frankemcgarvey/seniorDesign/pictures/Capture.PNG

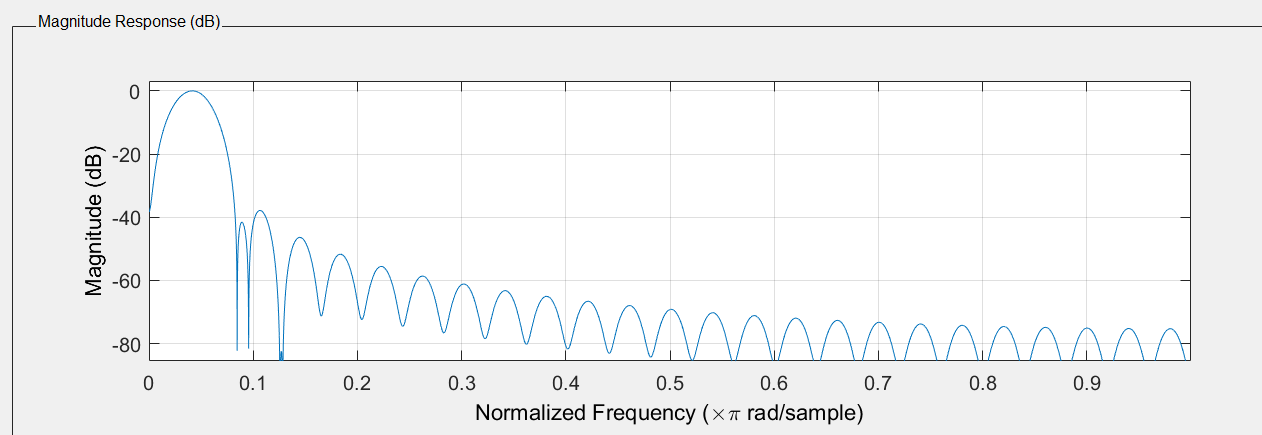
pictures/Capture.PNG
