frankemcgarvey/seniorDesign/Progress/Audio/251_tap_filter.PNG

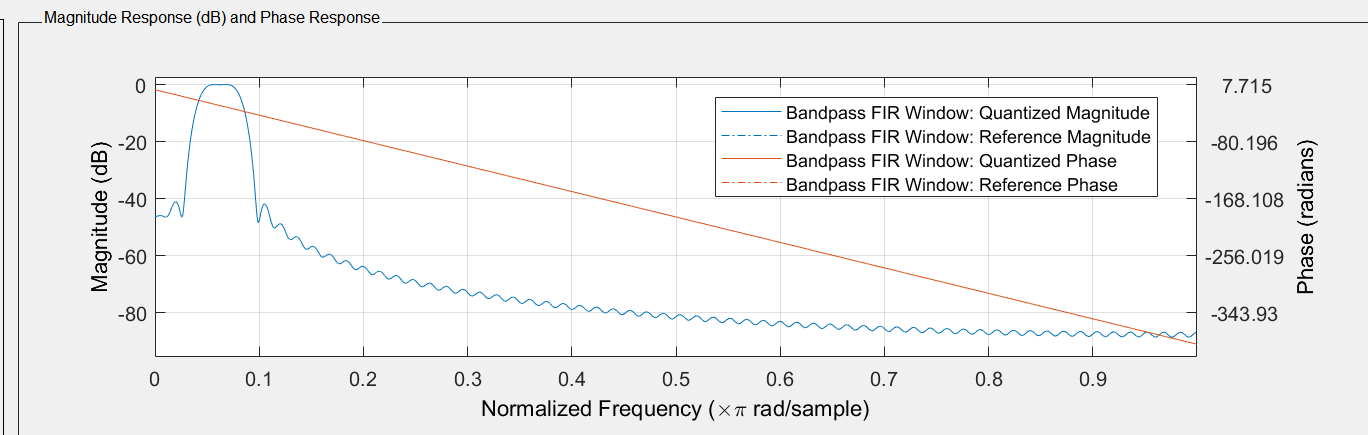
Progress/Audio/251_tap_filter.PNG
