frankemcgarvey/seniorDesign/Progress/Audio/clapping examples.PNG

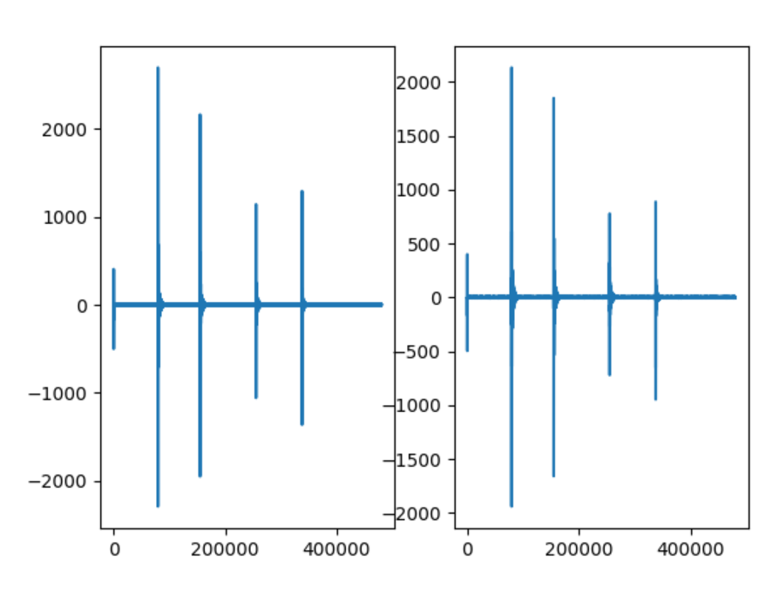
Progress/Audio/clapping examples.PNG
