frankemcgarvey/seniorDesign/Progress/Audio/FFT of 1khz-2khz clap.PNG

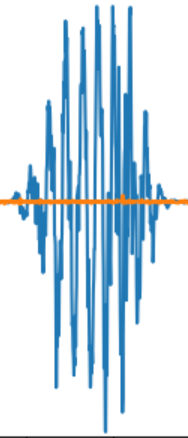
Progress/Audio/FFT of 1khz-2khz clap.PNG
