frankemcgarvey/seniorDesign/Progress/Audio/FFT of a 1khz and 3khz sine wave.PNG

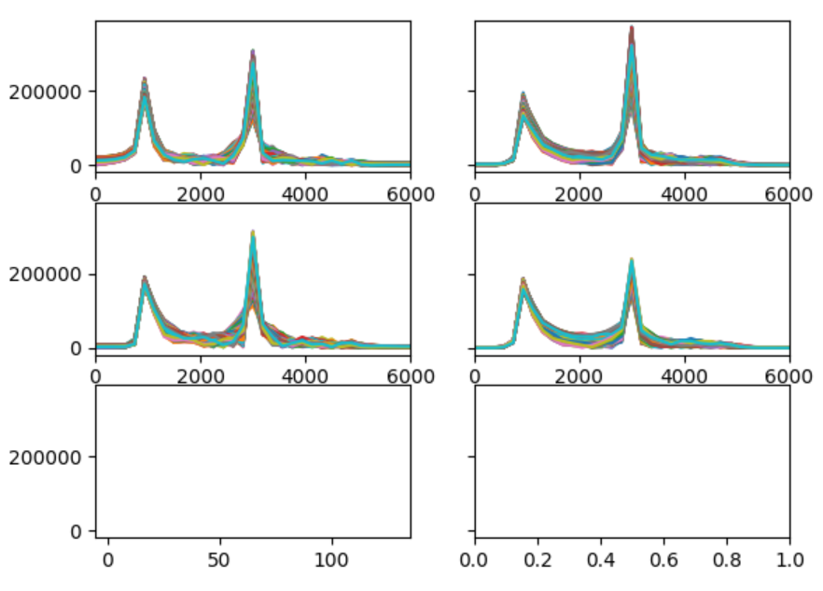
Progress/Audio/FFT of a 1khz and 3khz sine wave.PNG
