frankemcgarvey/seniorDesign/pictures/49_order.PNG

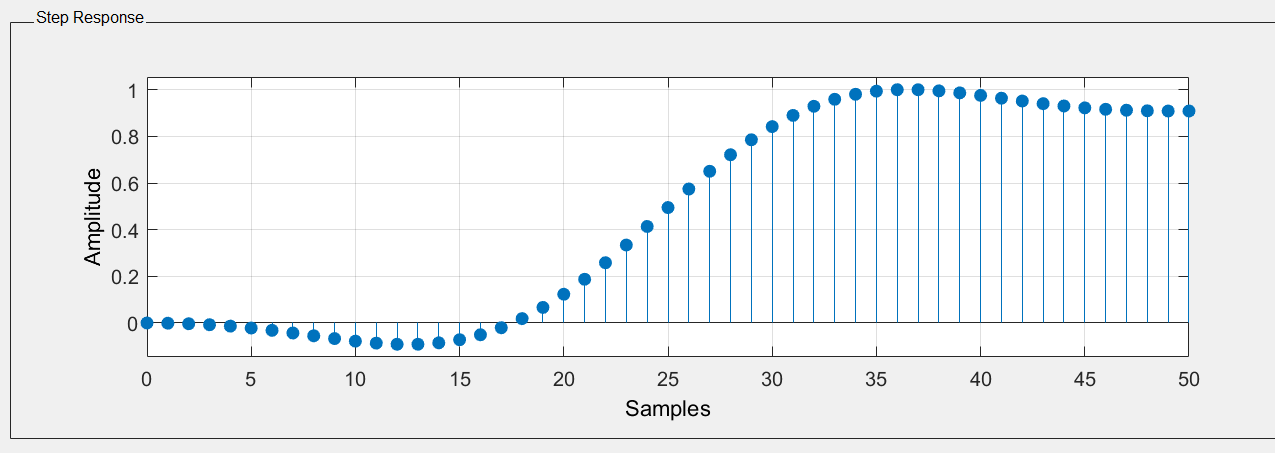
pictures/49_order.PNG
