frankemcgarvey/seniorDesign/pictures/99_order.PNG

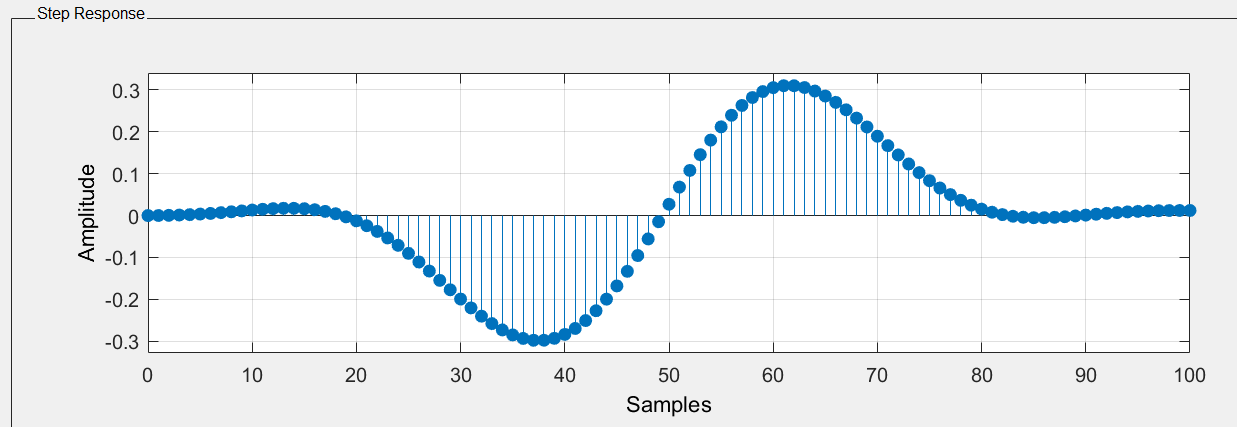
pictures/99_order.PNG
