frankemcgarvey/seniorDesign/PCB/mic_pcb/mic_pcb.kicad_pcb

## KiCad design PCB/mic_pcb/mic_pcb.kicad_pcb (2021-11-12)

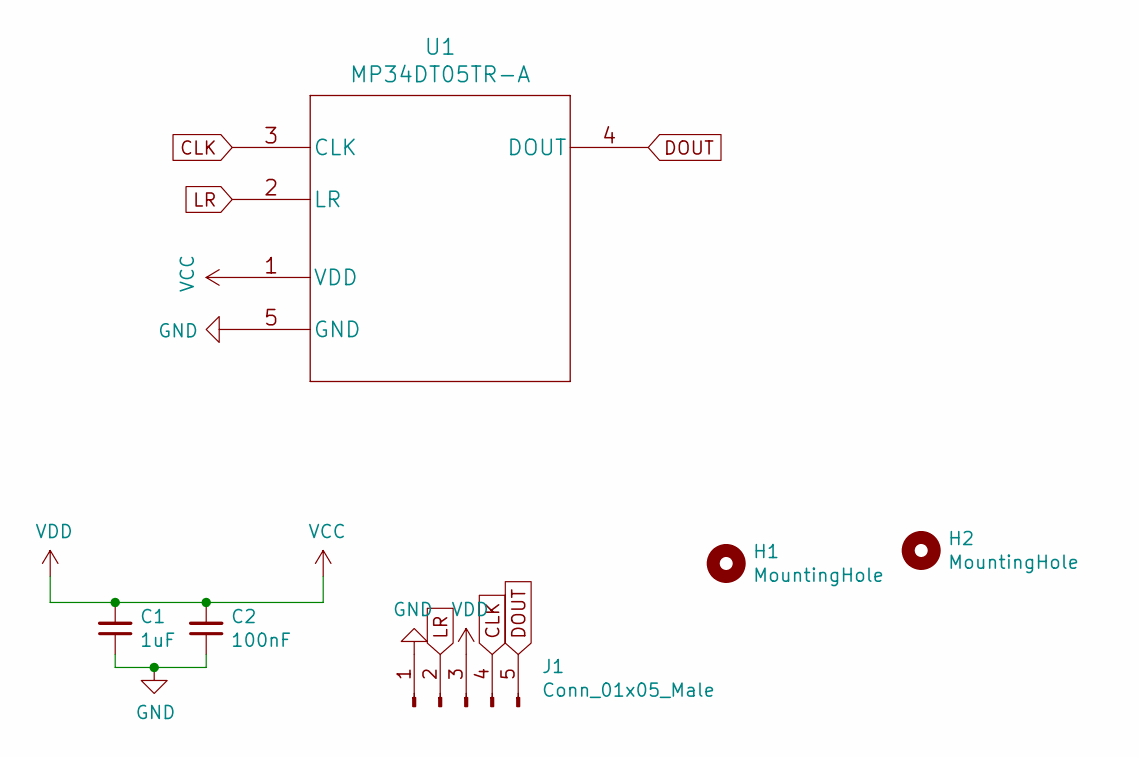
[picture p8: schematic mic_pcb.sch]

Parts:
C1: 1uF; C_0402_1005Metric; LCSC Part # C52923
C2: 100nF; C_0402_1005Metric; LCSC Part # C1525
H1, H2: MountingHole; MountingHole_2.2mm_M2_Pad_Via
J1: Conn_01x05_Male; PinHeader_1x05_P2.54mm_Vertical
U1: MP34DT05TR-A

Connections:
CLK: J1.4, U1.3 (CLK)
DOUT: J1.5, U1.4 (DOUT)
GND: C1.1, C2.1, J1.1, U1.5 (GND)
LR: J1.2, U1.2 (LR)
VCC: C1.2, C2.2, J1.3, U1.1 (VDD)

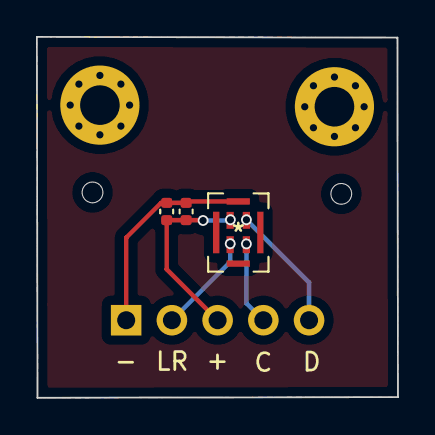
[picture p9: board mic_pcb.kicad_pcb from above]

Board: 2 copper layers, 20.1 x 20.0 mm, 6 parts (0 on the bottom side), 5 nets.
