frankemcgarvey/seniorDesign/PCB/stm32_pcb/stm32_pcb.kicad_pcb

## KiCad design PCB/stm32_pcb/stm32_pcb.kicad_pcb (2021-11-12)

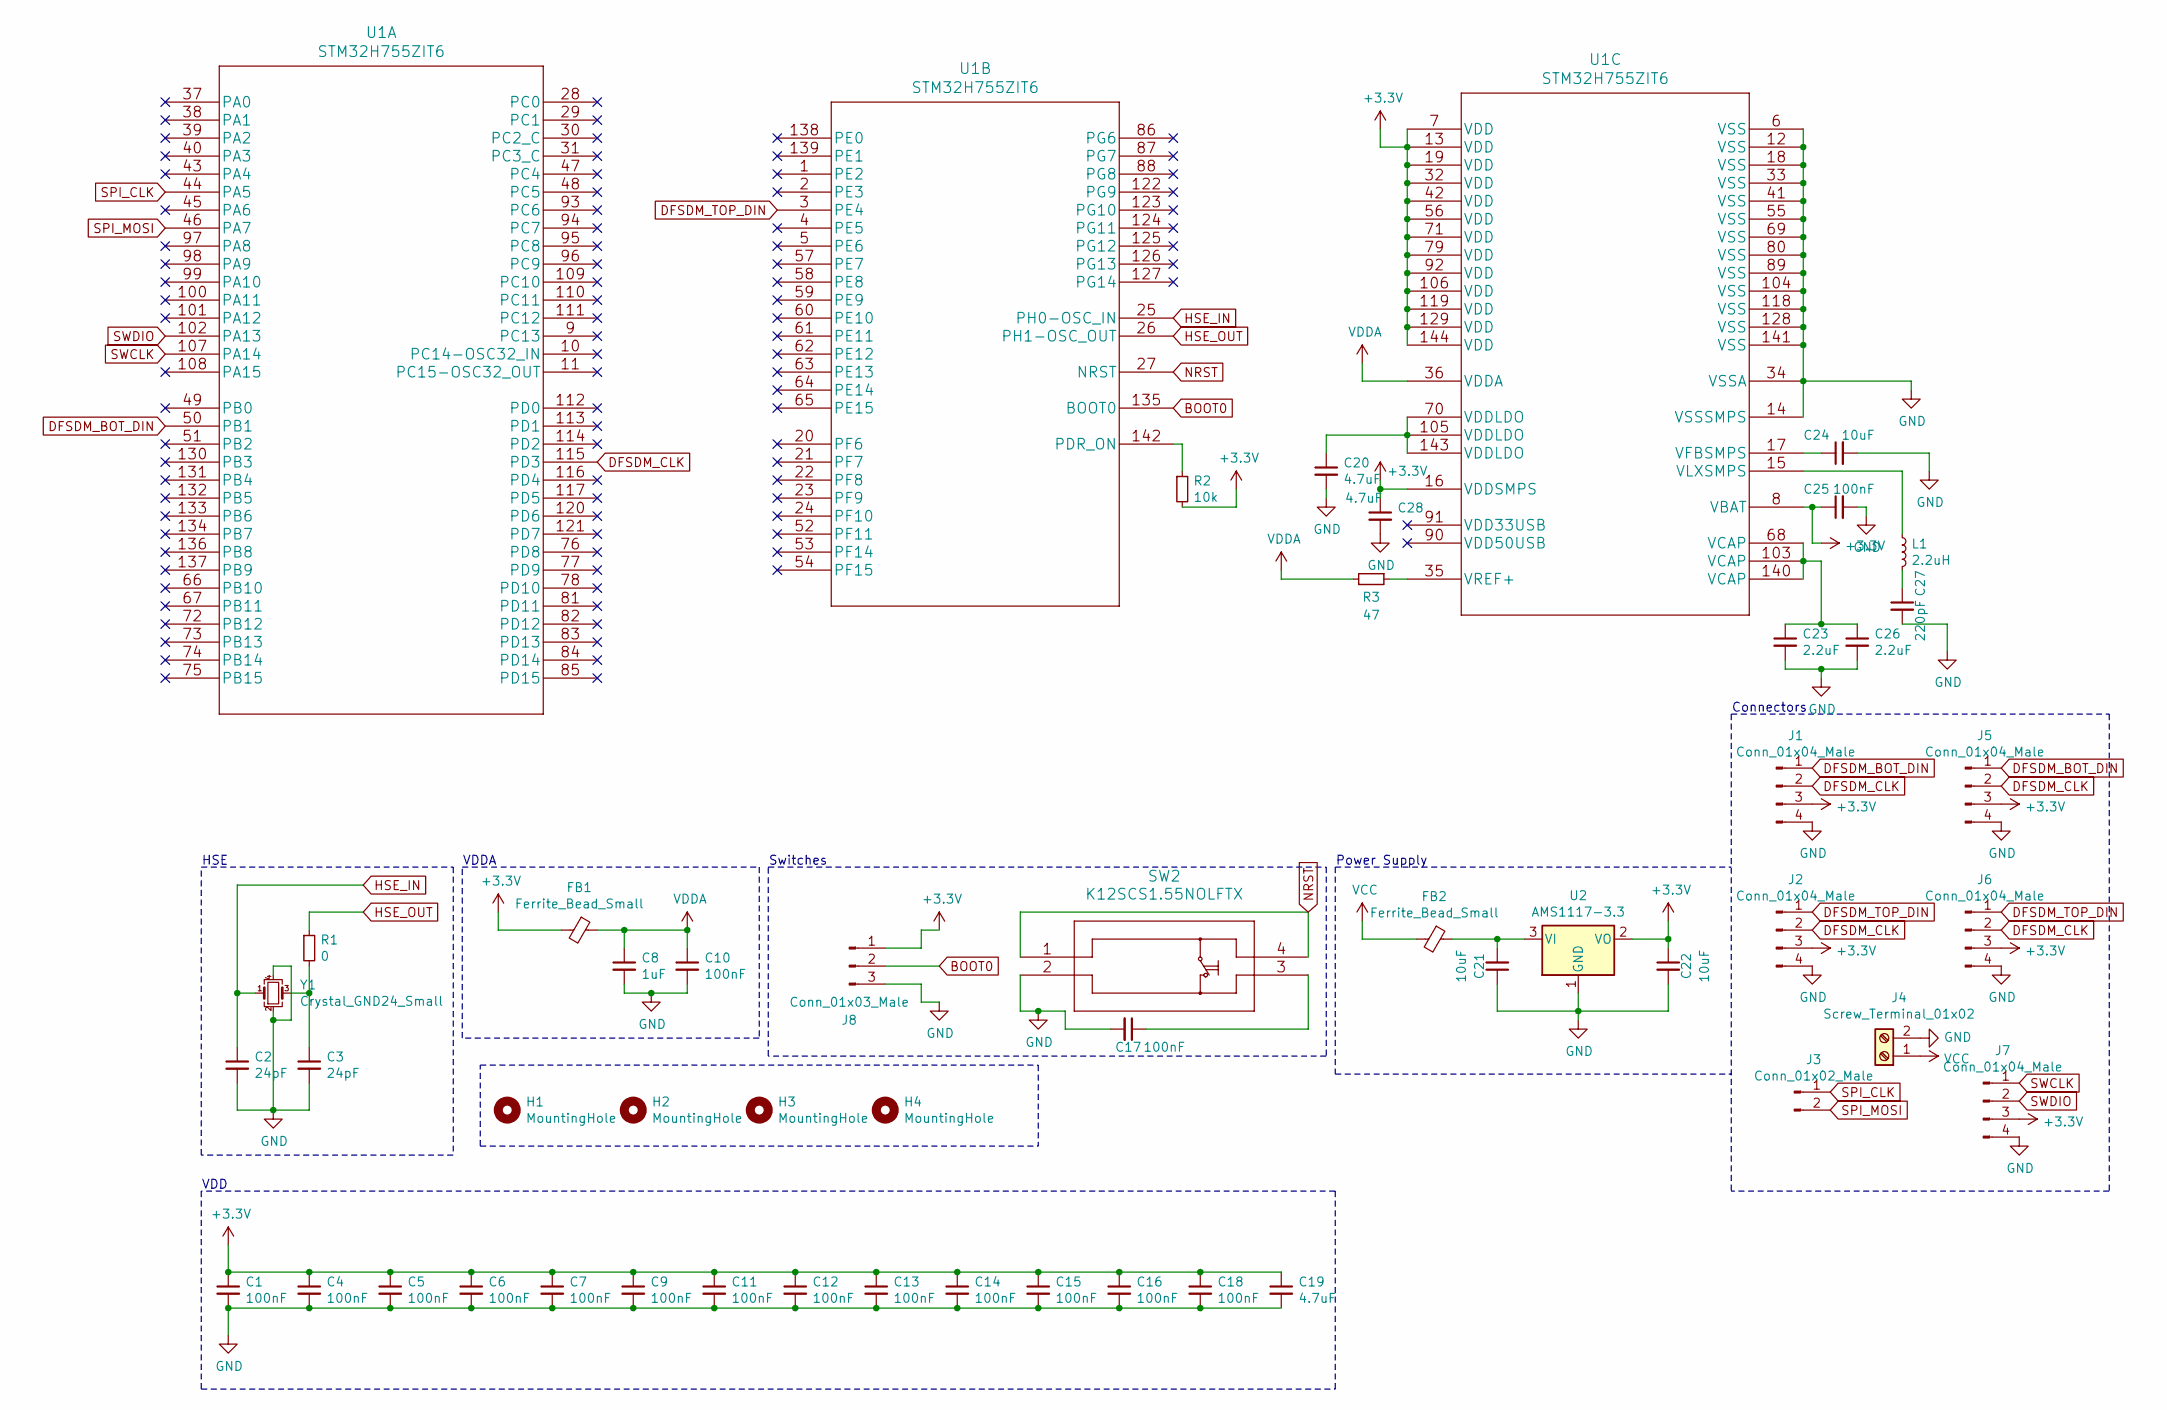
[picture p10: schematic stm32_pcb.sch]

Parts:
C1, C4, C5, C6, C7, C9, C10, C11, C12, C13, C14, C15, C16, C17, C18, C25: 100nF; C_0402_1005Metric; LCSC Part # C1525
C2, C3: 24pF; C_0402_1005Metric; LCSC Part # C22728
C8: 1uF; C_0402_1005Metric; LCSC Part # C52923
C19, C20, C28: 4.7uF; C_0402_1005Metric; LCSC Part # C23733
C21, C22: 10uF; C_0805_2012Metric; LCSC Part # C15850
C23, C26: 2.2uF; C_0402_1005Metric; LCSC Part # C12530
C24: 10uF; C_0402_1005Metric; LCSC Part # C15525
C27: 220pF; C_0402_1005Metric; LCSC Part # C1530
FB1, FB2: Ferrite_Bead_Small; L_0805_2012Metric; LCSC Part # C1015
H1, H2, H3, H4: MountingHole; MountingHole_4.3mm_M4_Pad_Via
J1, J2, J5, J6, J7: Conn_01x04_Male; PinHeader_1x04_P2.54mm_Vertical
J3: Conn_01x02_Male; PinHeader_1x02_P2.54mm_Vertical
J4: Screw_Terminal_01x02; TerminalBlock_Phoenix_PT-1,5-2-3.5-H_1x02_P3.50mm_Horizontal
J8: Conn_01x03_Male; PinHeader_1x03_P2.54mm_Vertical
L1: 2.2uH; L_0805_2012Metric; LCSC Part # C1043
R1: 0; R_0402_1005Metric; LCSC Part # C17168
R2: 10k; R_0402_1005Metric; LCSC Part # C25744
R3: 47; R_0402_1005Metric; LCSC Part # C25118
SW2: K12SCS1.55NOLFTX
U1: STM32H755ZIT6
U2: AMS1117-3.3; SOT-223-3_TabPin2; LCSC Part # C6186
Y1: Crystal_GND24_Small; OSC_ABM3B-8.000MHZ-B2-T; LCSC Part # C83312

Connections:
+3V3: C1.1, C4.1, C5.1, C6.1, C7.1, C9.1, C11.1, C12.1, C13.1, C14.1, C15.1, C16.1, C18.1, C19.1, C22.1, C25.1, C28.1, FB1.2, J1.3, J2.3, J5.3, J6.3, J7.3, J8.1, R2.2, U1.7 (VDD), U1.8 (VBAT), U1.13 (VDD), U1.16 (VDDSMPS), U1.19 (VDD), U1.32 (VDD), U1.42 (VDD), U1.56 (VDD), U1.71 (VDD), U1.79 (VDD), U1.92 (VDD), U1.106 (VDD), U1.119 (VDD), U1.129 (VDD), U1.144 (VDD), U2.2 (VO)
BOOT0: J8.2, U1.135 (BOOT0)
DFSDM_BOT_DIN: J1.1, J5.1, U1.50 (PB1)
DFSDM_CLK: J1.2, J2.2, J5.2, J6.2, U1.115 (PD3)
DFSDM_TOP_DIN: J2.1, J6.1, U1.3 (PE4)
GND: C1.2, C2.2, C3.2, C4.2, C5.2, C6.2, C7.2, C8.2, C9.2, C10.2, C11.2, C12.2, C13.2, C14.2, C15.2, C16.2, C17.2, C18.2, C19.2, C20.2, C21.1, C22.2, C23.2, C24.2, C25.2, C26.2, C27.2, C28.2, J1.4, J2.4, J4.2, J5.4, J6.4, J7.4, J8.3, SW2.2, U1.6 (VSS), U1.12 (VSS), U1.14 (VSSSMPS), U1.18 (VSS), U1.33 (VSS), U1.34 (VSSA), U1.41 (VSS), U1.55 (VSS), U1.69 (VSS), U1.80 (VSS), U1.89 (VSS), U1.104 (VSS), U1.118 (VSS), U1.128 (VSS), U1.141 (VSS), U2.1 (GND), Y1.2, Y1.4
HSE_IN: C2.1, U1.25 (PH0-OSC_IN), Y1.1
HSE_OUT: R1.1, U1.26 (PH1-OSC_OUT)
NRST: SW2.1, SW2.4, U1.27 (NRST)
unnamed: C3.1, R1.2, Y1.3
unnamed: C17.1, SW2.3
unnamed: C20.1, U1.70 (VDDLDO), U1.105 (VDDLDO), U1.143 (VDDLDO)
unnamed: C21.2, FB2.1, U2.3 (VI)
unnamed: C23.1, C26.1, U1.68 (VCAP), U1.103 (VCAP), U1.140 (VCAP)
unnamed: C24.1, U1.17 (VFBSMPS)
unnamed: C27.1, L1.2
unnamed: L1.1, U1.15 (VLXSMPS)
unnamed: R2.1, U1.142 (PDR_ON)
unnamed: R3.1, U1.35 (VREF+)
SPI_CLK: J3.1, U1.44 (PA5)
SPI_MOSI: J3.2, U1.46 (PA7)
SWCLK: J7.1, U1.107 (PA14)
SWDIO: J7.2, U1.102 (PA13)
VCC: FB2.2, J4.1
VDDA: C8.1, C10.1, FB1.1, R3.2, U1.36 (VDDA)

Notes on the sheet:
HSE
VDDA
Switches
VDD
Power Supply
Connectors

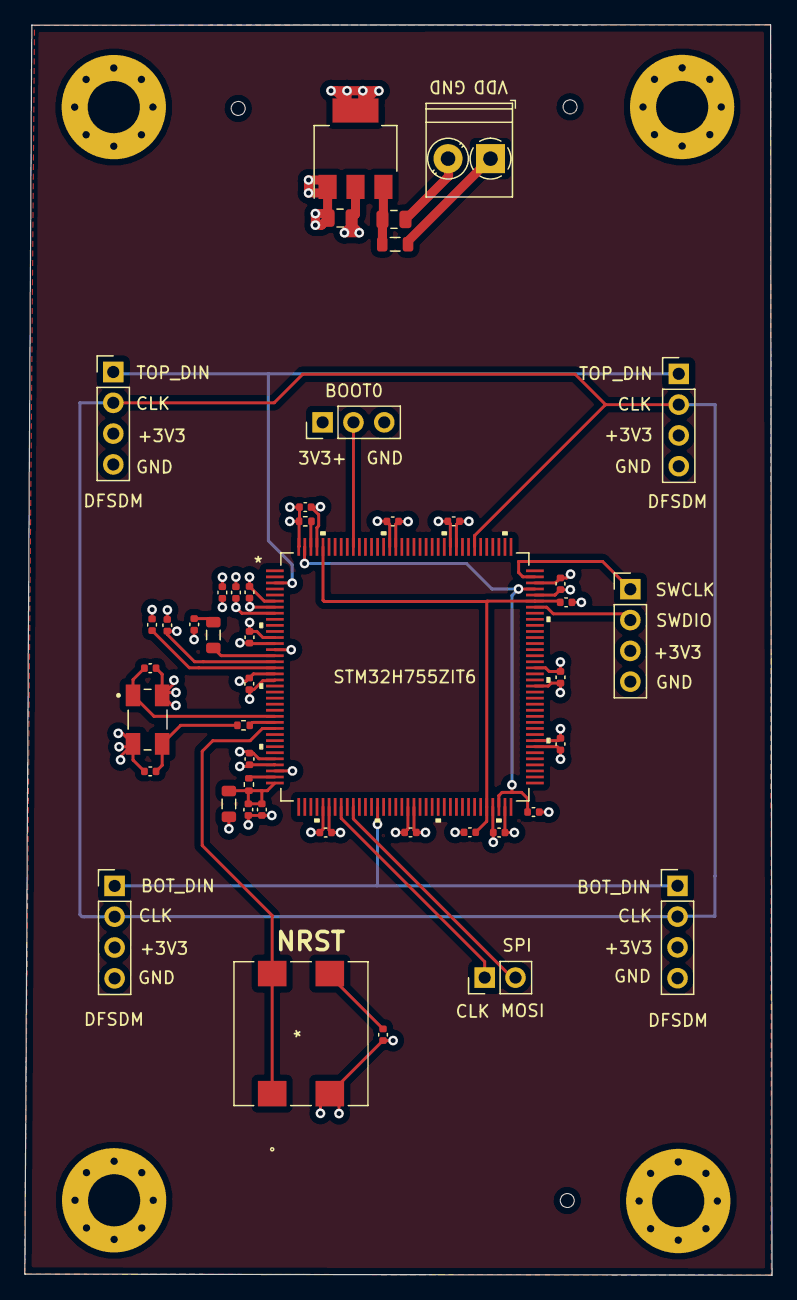
[picture p11: board stm32_pcb.kicad_pcb from above]

Board: 4 copper layers, 61.6 x 103.1 mm, 50 parts (0 on the bottom side), 25 nets.
