frankemcgarvey/seniorDesign/seniorProject/SPI_relay/SPI_relay.ioc

PB14.GPIO_Label=LD3 [Red Led]
PB13.Signal=ETH_TXD1
PG13.Signal=ETH_TXD0
PE1.Signal=GPIO_Output
PA8.Signal=USB_OTG_FS_SOF
PD9.GPIO_Label=STLINK_TX
PC13.Signal=GPIO_Input
PD10.Signal=GPIO_Output
PA9.Signal=USB_OTG_FS_VBUS
PB10.Signal=SPI2_SCK
PB14.Signal=GPIO_Output
PA5.Signal=SPI1_SCK
PE1.GPIO_Label=LD2 [Yellow Led]
PG7.GPIO_Label=USB_OTG_FS_OVCR
PA11.Signal=USB_OTG_FS_DM
PB0.Signal=GPIO_Output
PC1.Signal=ETH_MDC
Mcu.UserName=STM32H755ZITx
PB0.GPIO_Label=LD1 [Green Led]
PC13.GPIO_Label=B1 [Blue PushButton]
PG11.Signal=ETH_TX_EN
PA12.Signal=USB_OTG_FS_DP
PC2_C.Signal=SPI2_MISO
PA6.Signal=SPI1_MISO
PC5.Signal=ETH_RXD1
PG7.Signal=GPXTI7
PC4.Signal=ETH_RXD0
PD9.Signal=USART3_RX
PD10.GPIO_Label=USB_OTG_FS_PWR_EN
PA1.Signal=ETH_REF_CLK
PA2.Signal=ETH_MDIO
PA7.Signal=ETH_CRS_DV
