frankemcgarvey/seniorDesign/senior_project/microphone/CM7/Core/Src/main.c

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
/* Includes ------------------------------------------------------------------*/
#include "main.h"

/* USER CODE BEGIN Includes */
#include "stdbool.h"
/* USER CODE END Includes */

/* USER CODE BEGIN PTD */


typedef enum{
	NONE,
	BUSY,
	READY,
	DONE,
	HALF,
	FULL,
}flag_t;

/* USER CODE END PTD */

/* USER CODE BEGIN PD */

#ifndef HSEM_ID_0
#define HSEM_ID_0 (0U) /* HW semaphore 0*/
#endif


/* USER CODE END PD */


CRC_HandleTypeDef hcrc;

SAI_HandleTypeDef hsai_BlockA1;
DMA_HandleTypeDef hdma_sai1_a;

TIM_HandleTypeDef htim1;

UART_HandleTypeDef huart3;
DMA_HandleTypeDef hdma_usart3_tx;

/* USER CODE BEGIN PV */

static volatile flag_t dmaFlag = NONE;
static volatile flag_t timFlag = NONE;
static buffer_t * const buffer = (buffer_t *) 0x30000000;
static dsp_buffer_t dsp[CHANNEL_NUMBER];
static float coeff[TAPS] = {-0.0000001708, -0.0000002072, -0.0000002839, -0.0000004056, -0.0000005722, -0.0000007792, -0.0000010175, -0.0000012738, -0.0000015317, -0.0000017714, -0.0000019718, -0.0000021107, -0.0000021664, -0.0000021195, -0.0000019540, -0.0000016590, -0.0000012305, -0.0000006729, 0.0000000000, 0.0000007640, 0.0000015840, 0.0000024139, 0.0000031980, 0.0000038724, 0.0000043672, 0.0000046105, 0.0000045326, 0.0000040711, 0.0000031769, 0.0000018207, 0.0000000000, -0.0000022540, -0.0000048702, -0.0000077314, -0.0000106698, -0.0000134641, -0.0000158383, -0.0000174636, -0.0000179629, -0.0000169184, -0.0000138833, -0.0000083961, 0.0000000000, 0.0000117360, 0.0000271918, 0.0000466687, 0.0000703603, 0.0000983228, 0.0001304450, 0.0001664201, 0.0002057210, 0.0002475790, 0.0002909693, 0.0003346029, 0.0003769283, 0.0004161424, 0.0004502125, 0.0004769106, 0.0004938592, 0.0004985898, 0.0004886130, 0.0004614993, 0.0004149700, 0.0003469949, 0.0002558953, 0.0001404502, -0.0000000000, -0.0001654534, -0.0003551552, -0.0005675193, -0.0008000660, -0.0010493804, -0.0013110950, -0.0015799000, -0.0018495834, -0.0021131027, -0.0023626911, -0.0025899960, -0.0027862496, -0.0029424720, -0.0030496991, -0.0030992355, -0.0030829236, -0.0029934247, -0.0028245046, -0.0025713127, -0.0022306510, -0.0018012194, -0.0012838305, -0.0006815852, 0.0000000000, 0.0007529215, 0.0015666786, 0.0024283314, 0.0033226281, 0.0042322059, 0.0051378626, 0.0060188994, 0.0068535269, 0.0076193302, 0.0082937833, 0.008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

  /* Enable D-Cache---------------------------------------------------------*/
  SCB_EnableDCache();

  /* MCU Configuration--------------------------------------------------------*/

  /* Reset of all peripherals, Initializes the Flash interface and the Systick. */
  HAL_Init();

  /* Configure the system clock */
  SystemClock_Config();
/* USER CODE BEGIN Boot_Mode_Sequence_2 */
/* When system initialization is finished, Cortex-M7 will release Cortex-M4 by means of
HSEM notification */
/*HW semaphore Clock enable*/
__HAL_RCC_HSEM_CLK_ENABLE();
/*Take HSEM */
HAL_HSEM_FastTake(HSEM_ID_0);
/*Release HSEM in order to notify the CPU2(CM4)*/
HAL_HSEM_Release(HSEM_ID_0,0);
/* wait until CPU2 wakes up from stop mode */
timeout = 0xFFFF;
while((__HAL_RCC_GET_FLAG(RCC_FLAG_D2CKRDY) == RESET) && (timeout-- > 0));
if ( timeout < 0 )
{
Error_Handler();
}
/* USER CODE END Boot_Mode_Sequence_2 */

  /* Initialize all configured peripherals */
  MX_GPIO_Init();
  MX_DMA_Init();
  MX_USART3_UART_Init();
  MX_CRC_Init();
  MX_SAI1_Init();
  MX_TIM1_Init();
  /* USER CODE BEGIN 2 */

  FIR_Filter_Init(&dsp[0], &coeff[0]);

  pdm_to_pcm_init((PDM_Filter_Handler_t*)&PDM_FilterHandler[0], (PDM_Filter_Config_t*)&PDM_FilterConfig[0]);

  timFlag = NONE;
  /* USER CODE END 2 */

  /* Infinite loop */
  /* USER CODE BEGIN WHILE */

  HAL_SAI_Receive_DMA(&hsai_BlockA1, (uint8_t*)&buffer->pdmBuffer[0], BUFFER_SIZE);

  HAL_Delay(2000);

  HAL_TIM_Base_Start_IT(&htim1);

  while (timFlag != DONE){

	  //================
	  //Wait for Half of the buffer to be filled
	  while(dmaFlag != HALF){}
	  //Reset Flag
	  dmaFlag = NONE;
	  //Filter PDM to PCM
	  pdm_to_pcm(&PDM_FilterHandler[0],	(uint8_t*)&buffer->pdmBuffer[0], (uint16_t(*)[PCM_CHUNK_SIZE])&buffer->pcmBuffer[0][0]);
	  //Q15 to Float
	  Q15_To_Float((q15_t(*)[PCM_CHUNK_SIZE])&buffer->pcmBuffer[0][0], (float(*)[PCM_CHUNK_SIZE])&buffer->pcmBuffer_flt[0][0]);
	  //FIR Filter
	  FIR_Filter(&dsp[0], (float(*)[PCM_CHUNK_SIZE])&buffer->pcmBuffer_flt[0][0], (float(*)[PCM_CHUNK_SIZE])&buffer->pcmBuffer_flt[0][0]);
	  //Clean
	  Clean((float*)&buffer->pcmBuffer_flt[0][0], 4*PCM_CHUNK_SIZE*CHANNEL_NUMBER);
	  //Transmit PCM
	  HAL_UART_Transmit_DMA(&huart3, (uint8_t*)&buffer->pcmBuffer_flt[0][0], 4*PCM_CHUNK_SIZE*CHANNEL_NUMBER);
	  //================

	  //================
	  //Wait for the second Half of the buffer to be filled
	  while(dmaFlag != FULL){}
	  //Reset Flag
	  dmaFlag = NONE;
	  //Filter PDM to PCM
	  pdm_to_pcm(&PDM_FilterHandler[0],	(uint8_t*)&buffer->pdmBuffer[BUFFER_SIZE/2], (uint16_t(*)[PCM_CHUNK_SIZE])&buffer->pcmBuffer[CHANNEL_NUMBER][0]);
	  //Q15 to Float
	  Q15_To_Float((q15_t(*)[PCM_CHUNK_SIZE])&buffer->pcmBuffer[CHANNEL_NUMBER][0], (float(*)[PCM_CHUNK_SIZE])&buffer->pcmBuffer_flt[CHANNEL_NUMBER][0]);
	  //FIR Filter
	  FIR_Filter(&dsp[0], (float(*)[PCM_CHUNK_SIZE])&buffer->pcmBuffer_flt[CHANNEL_NUMBER][0], (float(*)[PCM_CHUNK_SIZE])&buffer->pcmBuffer_flt[CHANNEL_NUMBER][0]);
	  //Clean
	  Clean((float*)&buffer->pcmBuffer_flt[CHANNEL_NUMBER][0], 4*PCM_CHUNK_SIZE*CHANNEL_NUMBER);
	  //Transmit PCM
	  HAL_UART_Transmit_DMA(&huart3, (uint8_t*)&buffer->pcmBuffer_flt[CHANNEL_NUMBER][0], 4*PCM_CHUNK_SIZE*CHANNEL_NUMBER);
	  //================
    /* USER CODE END WHILE */

    /* USER CODE BEGIN 3 */
  }



  while(1){}
  /* USER CODE END 3 */
}

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
/* USER CODE BEGIN 4 */

static void Clean(float *buffer, uint32_t byte){
	SCB_CleanDCache_by_Addr((uint32_t*)&buffer[0], byte);
}

void HAL_SAI_RxHalfCpltCallback(SAI_HandleTypeDef *hsai){
	dmaFlag = HALF;
}

void HAL_SAI_RxCpltCallback(SAI_HandleTypeDef *hsai){
	dmaFlag = FULL;
}

void HAL_TIM_PeriodElapsedCallback(TIM_HandleTypeDef *htim)
{
  if(htim == &htim1){
	  HAL_TIM_Base_Stop_IT(htim);
	  timFlag = DONE;
  }
}

/* USER CODE END 4 */
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
