frankemcgarvey/seniorDesign/(commit log)

2021-06-17 UART/SAI/PDM2PCM Implemented; more testing is needed
2021-06-23 Mic Testing Ready; configured for 10 secs of uploading through UART
2021-06-23 Correct amount of bytes are transfered; more testing needed
    [main.c, microphone.ioc]
2021-06-23 UART_DMA appears to NOT hang up while transmitting like calculations stated; there should be no bottle neck between SAI_RECEIVE_DMA & PDM2PCM & UART_SEND_DMA; going to test UART->PC data exchange
2021-06-23 UART->PC transfers correct amount of bytes; next testing is actual mics with 2 channels (i.e. 2 mics)
2021-06-25 Fixed Cache Sizes for Clean/Invalidate
    [main.c, microphone.ioc]
2021-06-30 4 Mics Work; onto filtering the mics for better quality
2021-07-08 Checkpoint: Working On GCC-PHAT; Need to make sure to change code to match new filter function
2021-07-26 Fixed FIR Filter Implementation, no noise is detedted now, bandpass FFT shows that the range is between 1k-2k
    [microphone.ioc]
2021-09-11 Checkpoint 9/11
    [PCB_design.kicad_pcb, mic.sch, stm32.kicad_pcb, stm32.sch]
2021-11-12 Checkpoint 11/12
    [PCB_design.kicad_pcb, mic.sch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]
